dzalf/Instrumentation-Single-and-Dual-Symmetric-SMPS/Proteus Design/2017-02-14 11_09_59-Power source for CS - Proteus 8 Professional - Schematic Capture.png

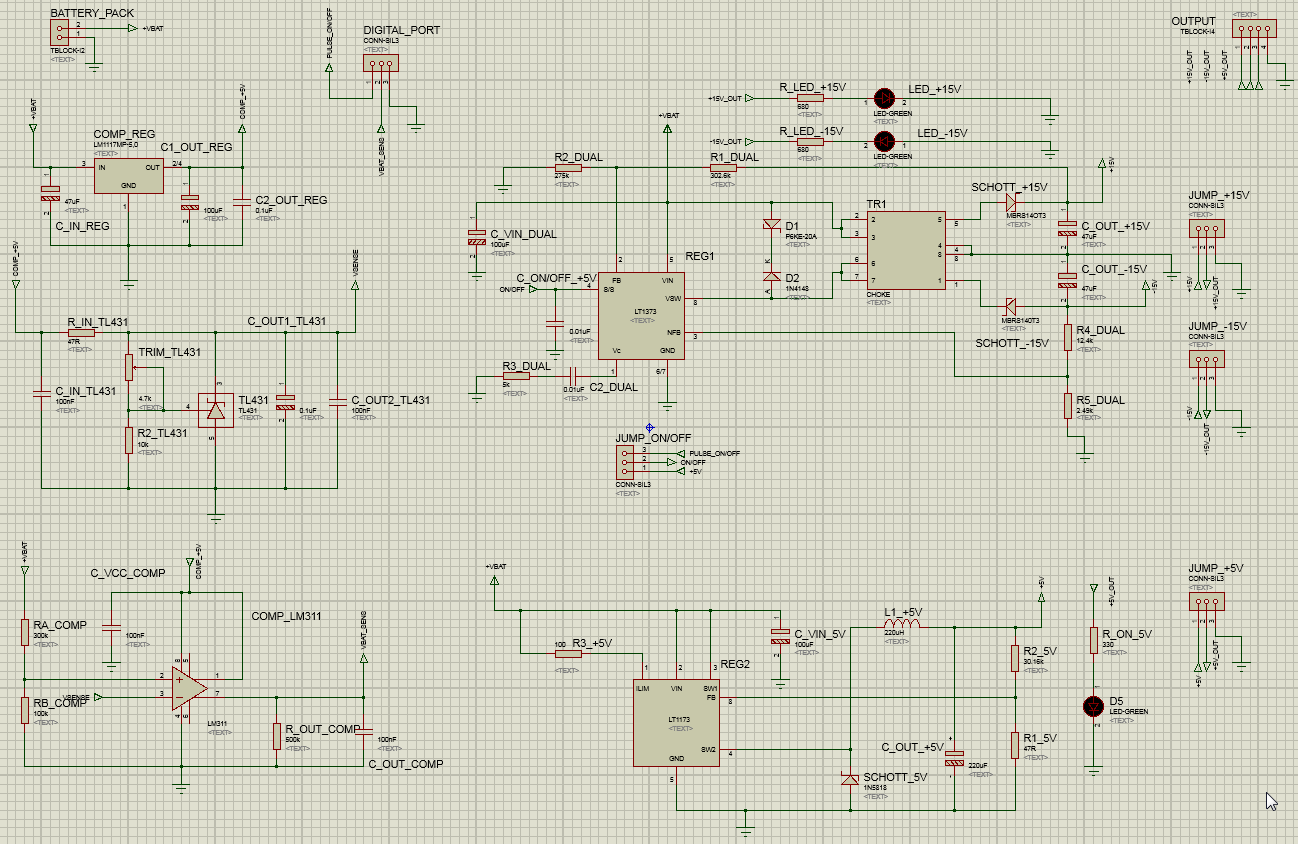
Proteus Design/2017-02-14 11_09_59-Power source for CS - Proteus 8 Professional - Schematic Capture.png
