dzalf/Instrumentation-Single-and-Dual-Symmetric-SMPS/Non-catalog components/2017-02-07 19_04_03-Nitro Pro 9.png

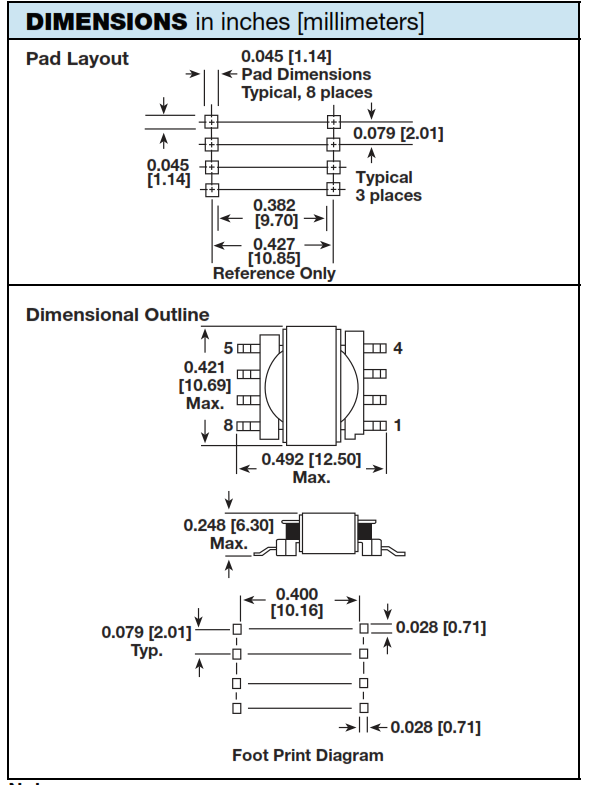
Non-catalog components/2017-02-07 19_04_03-Nitro Pro 9.png
