dzalf/Instrumentation-Single-and-Dual-Symmetric-SMPS/Non-catalog components/2017-02-13 22_55_22-1719389.pdf - Opera.png

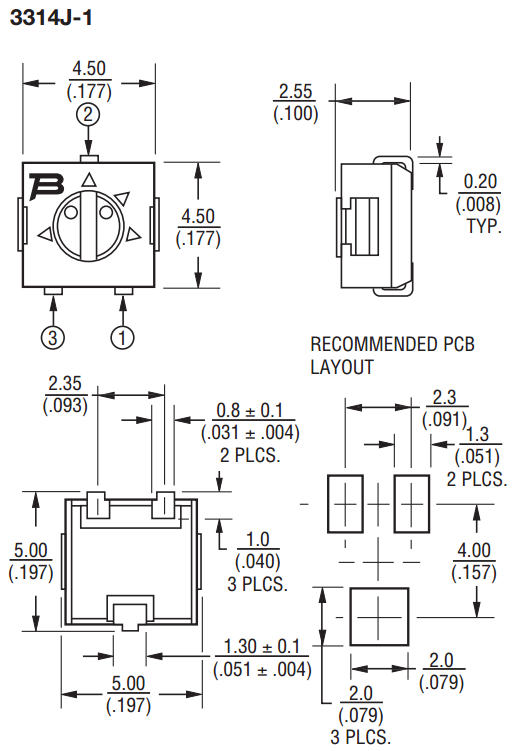
Non-catalog components/2017-02-13 22_55_22-1719389.pdf - Opera.png
