dzalf/Instrumentation-Single-and-Dual-Symmetric-SMPS/Proteus Design/ps_all layer.pdf

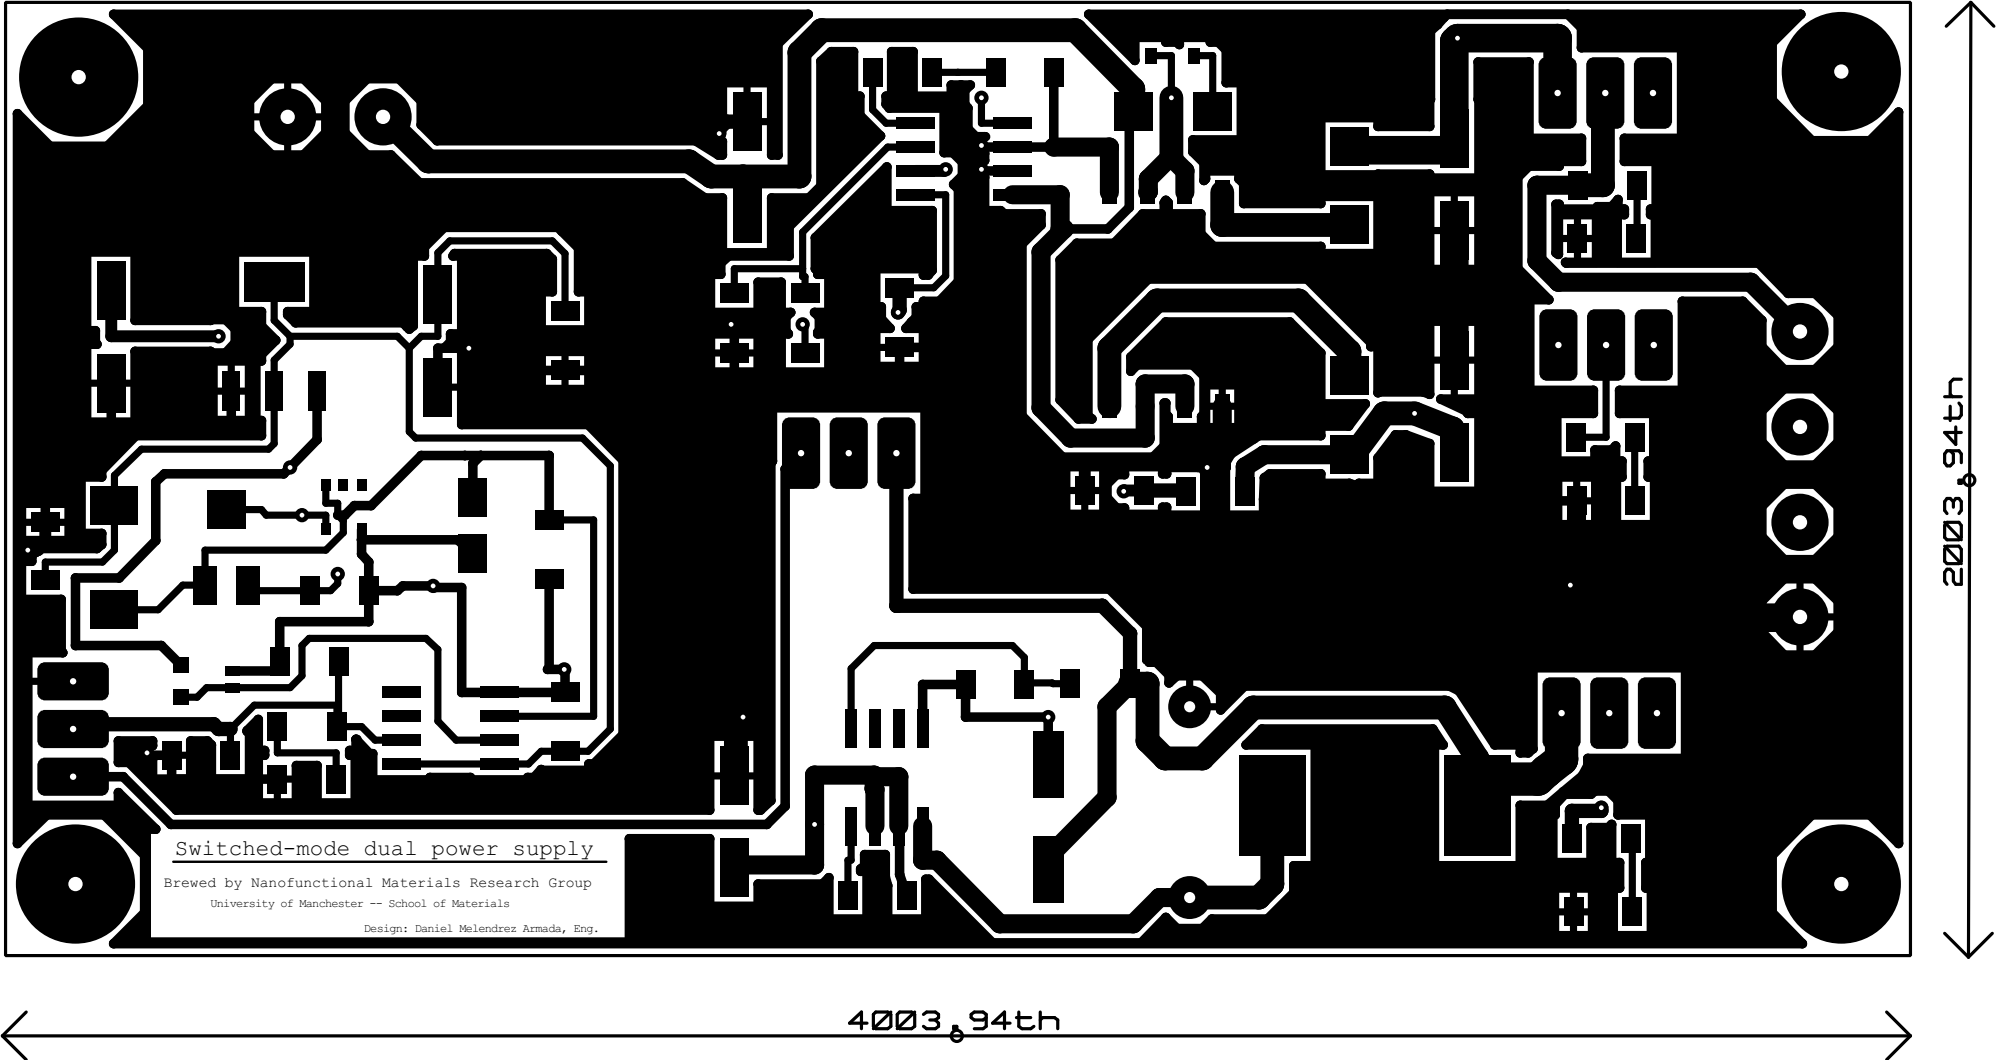
[picture p5: page 1]

Switched-mode dual power supply

University of Manchester -- School of Materials Brewed by Nanofunctional Materials Research Group

Design: Daniel Melendrez Armada, Eng.

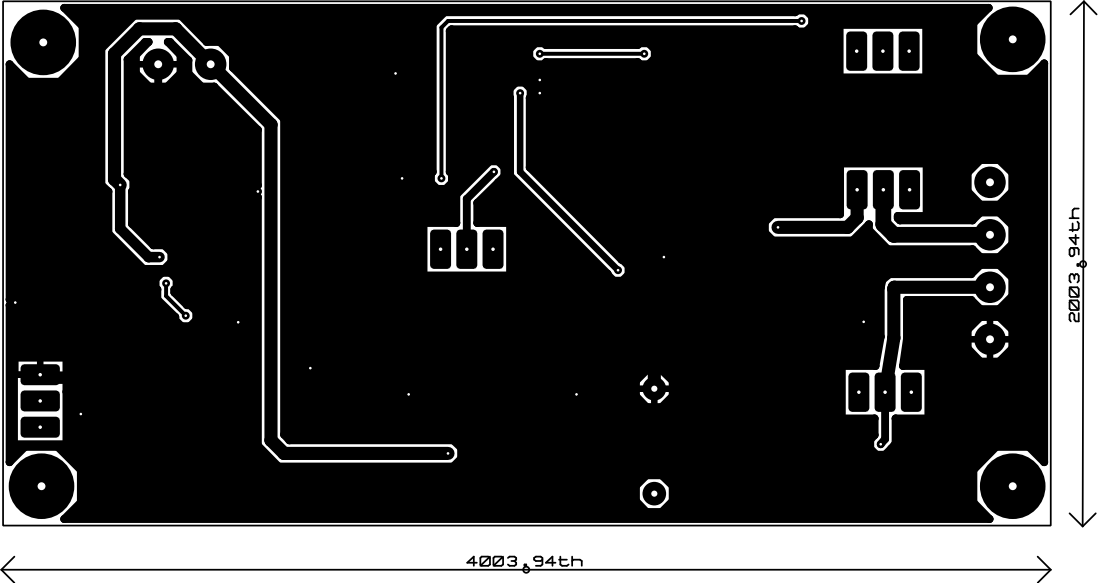
[picture p6: page 2]

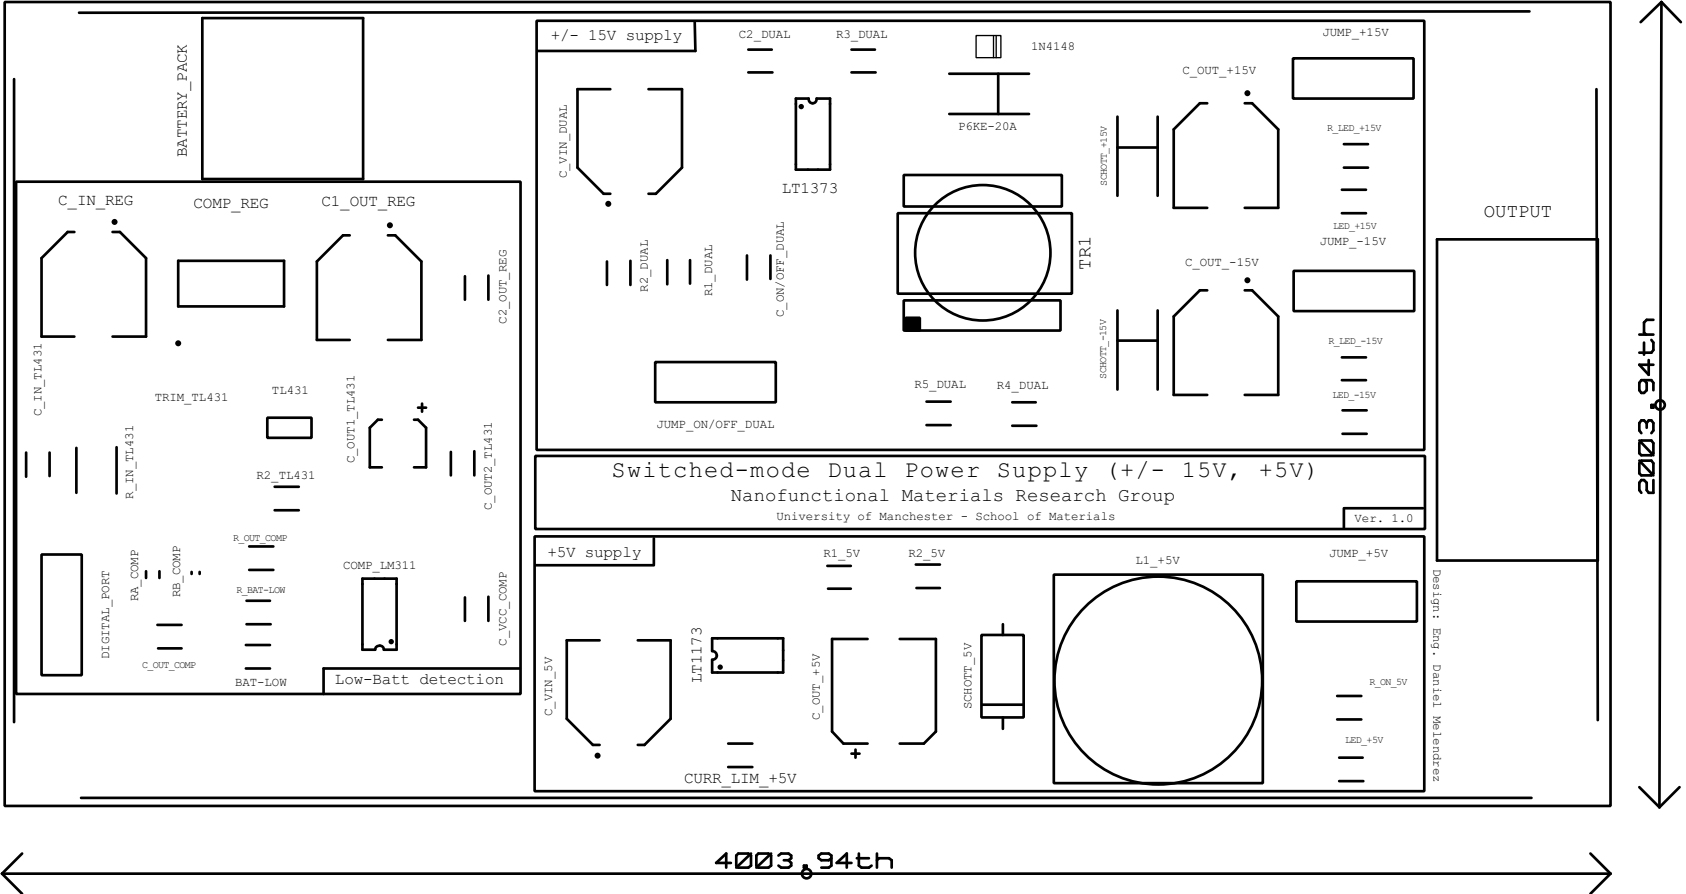
[picture p7: page 3]

Switched-mode Dual Power Supply (+/- 15V, +5V)

University of Manchester - School of Materials Nanofunctional Materials Research Group

Design: Eng. Daniel Melendrez

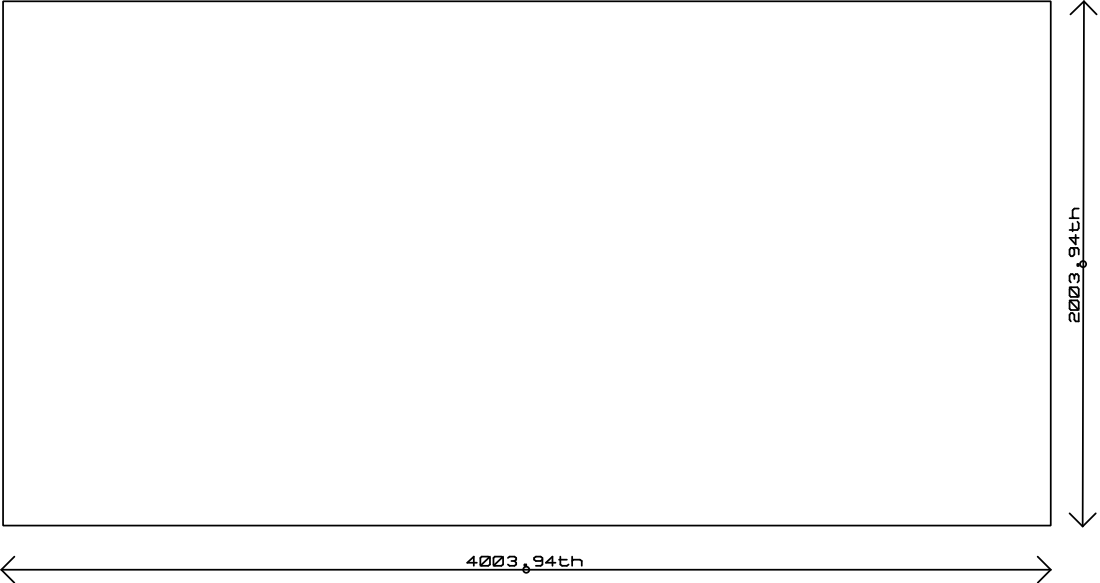
[picture p8: page 4]

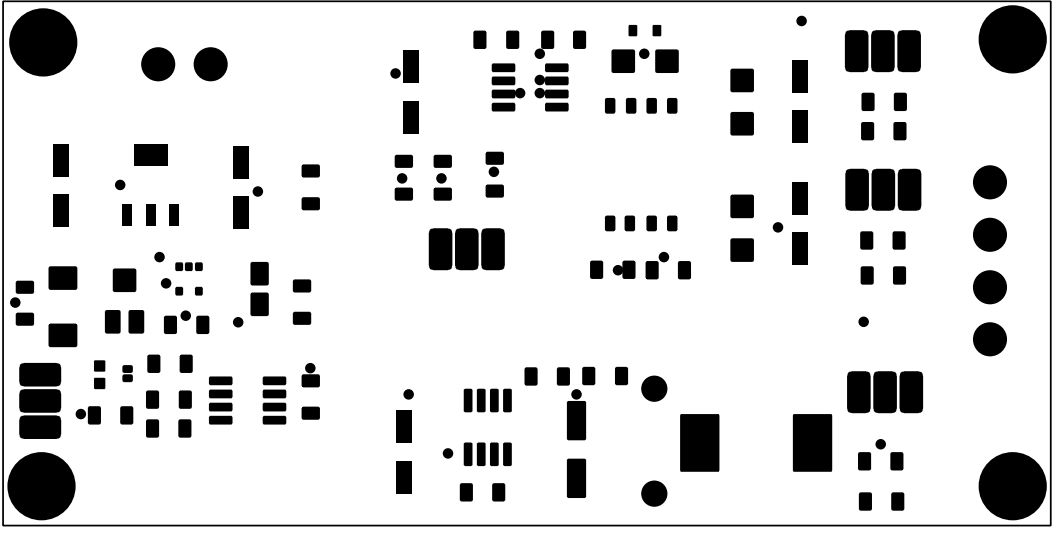
[picture p9: page 5]

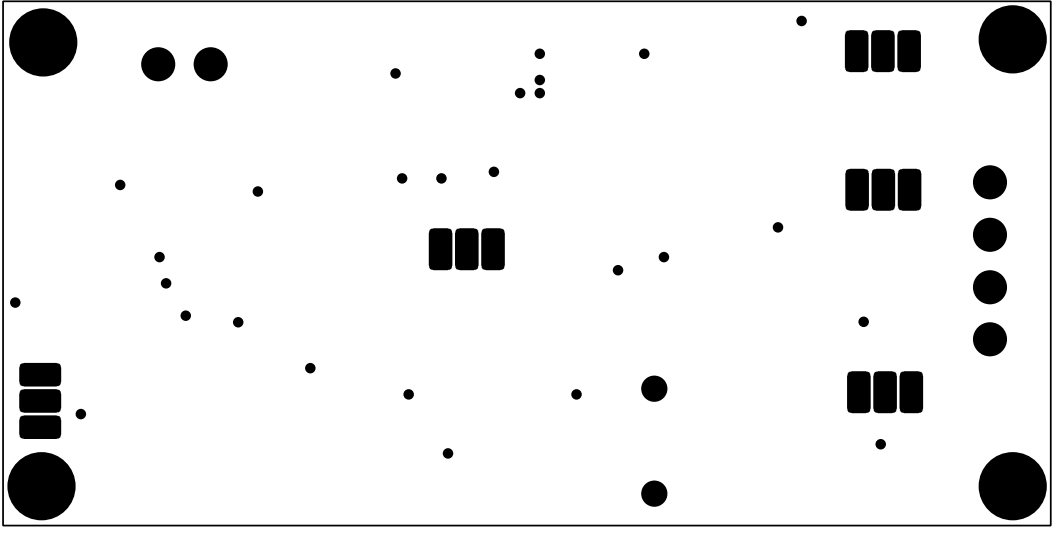
[picture p10: page 6]

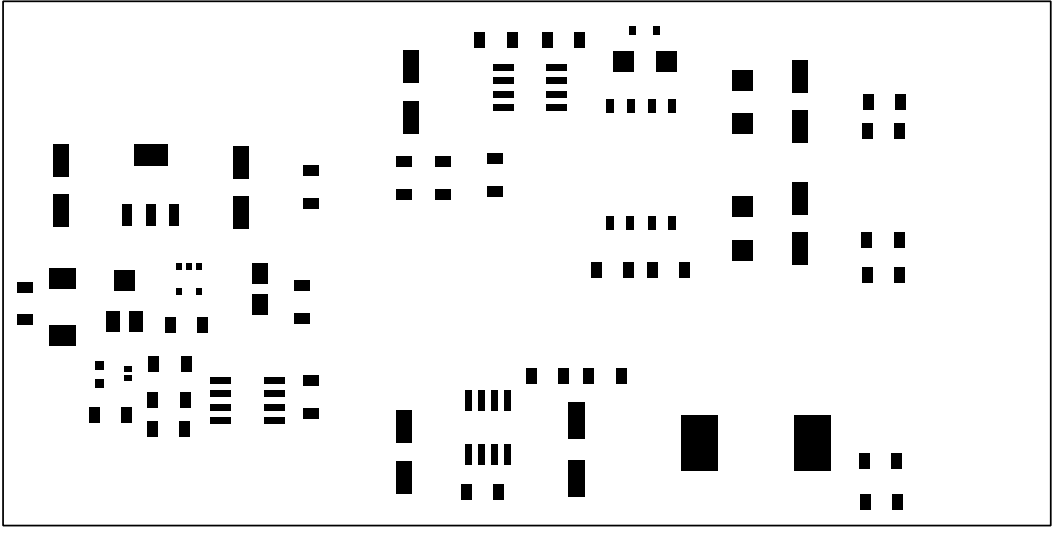
[picture p11: page 7]
