dzalf/Instrumentation-Single-and-Dual-Symmetric-SMPS/(list of files, drawings)

Other design files:
Non-catalog components/Bourns coil.pdsprj
Non-catalog components/TEST POINT SMD.pdsprj
Non-catalog components/Vishay_transformer.pdsprj
Proteus Design/Power source for CS.pdsprj
